DaQi0510/SignalCreater/盖章合同.docx

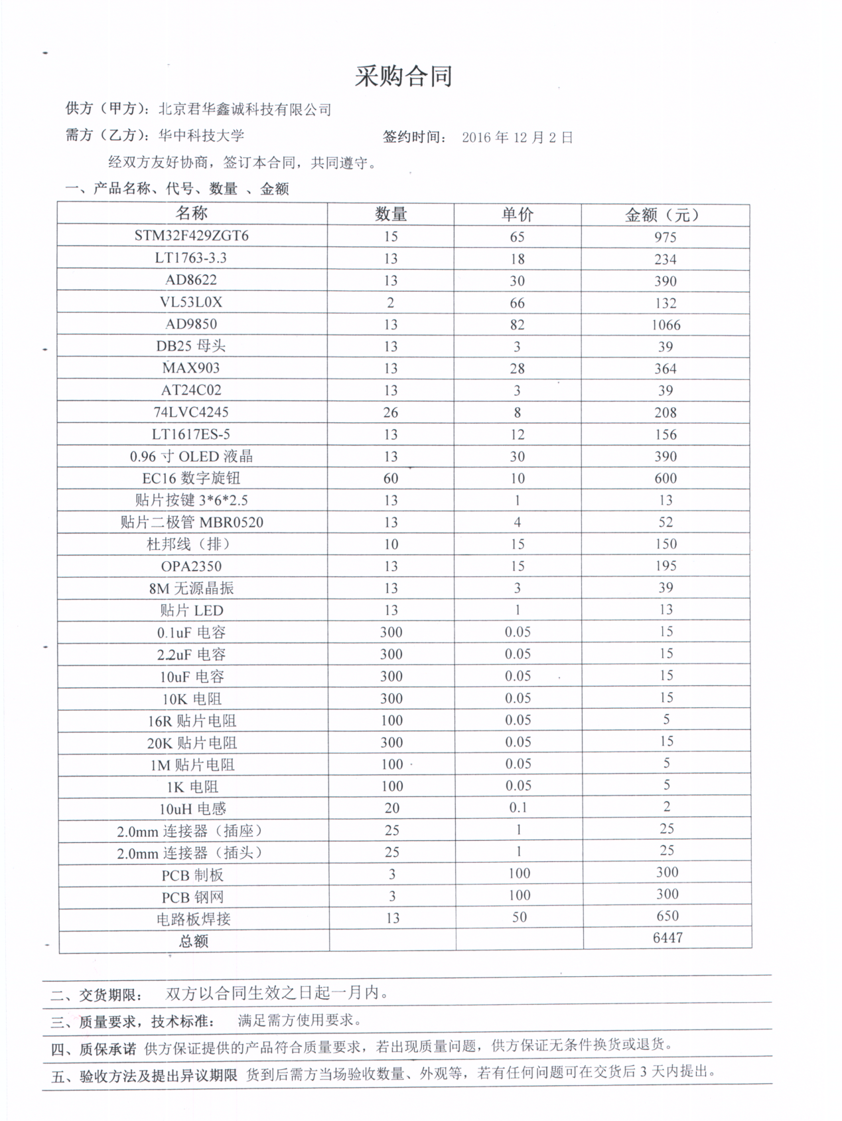
[picture p2: figure]
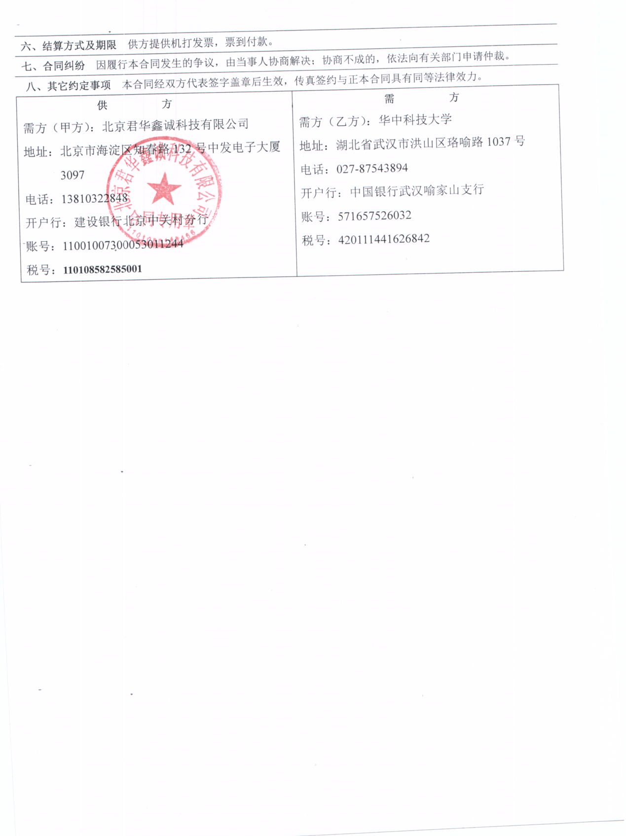
[picture p3: figure]
