DaQi0510/SignalCreater/合同要求/照片 011.jpg

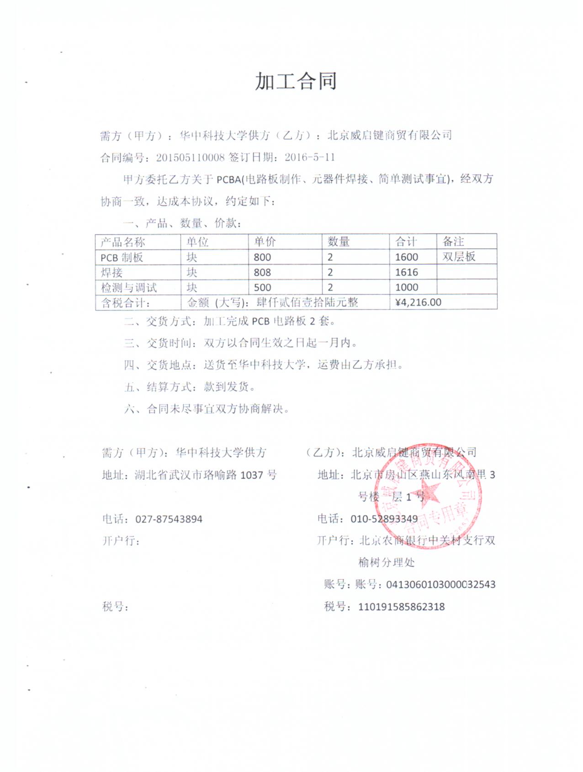
合同要求/照片 011.jpg
