DaQi0510/SignalCreater/合同要求/材料清单.docx

加工清单

付款单位：华中科技大学

产品名称 | 单位 | 单价 | 数量 | 合计 | 备注
PCB制板 | 块 | 800 | 2 | 1600 | 双层板
焊接 | 块 | 808 | 2 | 1616
检测与调试 | 块 | 500 | 2 | 1000
含税合计： | 金额 (大写)：肆仟贰佰壹拾陆元整 | | | ¥4,216.00
