DaQi0510/SignalCreater/金额明细.xlsx

购货单位：华中科技大学 （总计6447元）
名称 | 数量 | 单价 | 金额（元）
STM32F429ZGT6 | 15 | 65 | 975
LT1763-3.3 | 13 | 18 | 234
AD8622 | 13 | 30 | 390
VL53L0X | 2 | 66 | 132
AD9850 | 13 | 82 | 1066
DB25母头 | 13 | 3 | 39
MAX903 | 13 | 28 | 364
AT24C02 | 13 | 3 | 39
74LVC4245 | 26 | 8 | 208
LT1617ES-5 | 13 | 12 | 156
0.96寸OLED液晶 | 13 | 30 | 390
EC16数字旋钮 | 60 | 10 | 600
贴片按键3*6*2.5 | 13 | 1 | 13
贴片二极管MBR0520 | 13 | 4 | 52
杜邦线（排） | 10 | 15 | 150
OPA2350 | 13 | 15 | 195
8M无源晶振 | 13 | 3 | 39
贴片LED | 13 | 1 | 13
0.1uF电容 | 300 | 0.05 | 15
2.2uF电容 | 300 | 0.05 | 15
10uF电容 | 300 | 0.05 | 15
10K电阻 | 300 | 0.05 | 15
16R贴片电阻 | 100 | 0.05 | 5
20K贴片电阻 | 300 | 0.05 | 15
1M贴片电阻 | 100 | 0.05 | 5
1K电阻 | 100 | 0.05 | 5
10uH电感 | 20 | 0.1 | 2
2.0mm连接器（插座） | 25 | 1 | 25
2.0mm连接器（插头） | 25 | 1 | 25
PCB制板 | 3 | 100 | 300
PCB钢网 | 3 | 100 | 300
电路板焊接 | 13 | 50 | 650
