DaQi0510/SignalCreater/PCB/Ven2.0/DDS料单.xls

Comment | Footprint | Quantity | Value
Capacitor-0603 | 0603 | 200 | 0.1uF
Capacitor-0603 | 0603 | 20 | 4.7uF
Capacitor-0603 | 0603 | 20 | 10nF
Capacitor-0805 | 0805 | 20 | 0.47uF
Capacitor-0805 | 0805 | 20 | 4.7uF
Resistor-0603 | 0603 | 100 | 10k
Resistor-0603 | 0603 | 10 | 24.9k
Resistor-0603 | 0603 | 10 | 73.2k
DB25 | DB25母头 | 3 | DB25母头(90度弯角)
LED | LED-0805(红色) | 5 | LED
OPA2350 | SOIC 8P | 3
MAX903 | SOIC 8P | 3
AT24C02 | AT24C02 | 3 | 贴片
74LVC4245 | 74LVC4245-PW | 6
LT1617ES-5 | SOT23-5 | 3 | LT1617ES-5
LT1763-3.3 | LT1763-3.3 | 3 | 贴片
3225无源晶振 | 3225无源晶振 | 3 | 8M
贴片二极管 | 贴片二极管 | 10 | MBR0520
贴片按键3*6*2.5 |  | 10
STM32F407ZGT6 |  | 3
