DaQi0510/SignalCreater/(list of files, drawings)

Other design files:
PCB/Ven1.0/DDS/AD9851.SchDoc
PCB/Ven1.0/DDS/AD9851_2.SchDoc
PCB/Ven1.0/DDS/DDS.PrjPcb
PCB/Ven1.0/DDS/MCU.SchDoc
PCB/Ven1.0/DDS/Module.SchDoc
PCB/Ven1.0/DDS/Power.SchDoc
PCB/Ven1.0/DDS/Top.SchDoc
PCB/Ven2.0/DDS.PcbDoc
PCB/Ven2.0/DDS.PrjPcb
PCB/Ven2.0/DDS.SchDoc
PCB/Ven2.0/MCU.SchDoc
PCB/Ven2.0/Module.SchDoc
PCB/Ven2.0/Power.SchDoc
PCB/Ven2.0/TOP.SchDoc
