DaQi0510/SignalCreater/STM32F407/HARDWARE/AT24C02/AT24C02.h

#ifndef __AT24C02_H
#define __AT24C02_H

#include "stm32f4xx_gpio.h"
#include "stm32f4xx_rcc.h"
#include "sys.h"

//IO方向设置
#define AT24C02_SDA_IN()  {GPIOE->MODER&=~(3<<(12*2));GPIOE->MODER|=0<<12*2;}	//PD13输入模式
#define AT24C02_SDA_OUT() {GPIOE->MODER&=~(3<<(12*2));GPIOE->MODER|=1<<12*2;} //PD13输出模式
//IO操作函数	 
#define AT24C02_SCL    PEout(11)      //SCL
#define AT24C02_SDA    PEout(12)      //SDA	 
#define AT24C02_READ_SDA   PEin(12)   //读取SDA 

void SetDeviceInformation(u8 *Information,u8 Length);
void GetDeviceInformation(void);

void AT24C02_GPIO_Init(void);
void AT24C02_Init(void);
u8 AT24C02_ReadOneByte(u8 ReadAddr);
void AT24C02_WriteOneByte(u8 WriteAddr,u8 DataToWrite);
void AT24C02_Read(u8 ReadAddr,u8 *pBuffer,u8 NumToRead);
void AT24C02_Write(u8 WriteAddr,u8 *pBuffer,u8 NumToWrite);
void AT24C02_IIC_Start(void);
void AT24C02_IIC_Stop(void);
u8 AT24C02_IIC_Wait_Ack(void);
void AT24C02_IIC_Ack(void);
void AT24C02_IIC_NAck(void);
void AT24C02_Send_Byte(u8 TxData);
u8 AT24C02_Read_Byte(u8 Ack);

#endif
