DaQi0510/SignalCreater/(commit log)

2016-11-17 信号发生器第一版
    [AD9851.SchDoc, AD9851_2.SchDoc, DDS.CSV, DDS.PcbDoc, DDS.PrjPcb, DDS.SchDoc, DDS.xls, DDS1.xls]
2016-11-17 硬件改版
    [DDS.PrjPcb, DDS.SchDoc, DDS.xls, DDS料单.xls, MCU.SchDoc, Module.SchDoc, Power.SchDoc, TOP.SchDoc]
2016-11-22 硬件改版程序更新
    [DDS.PrjPcb]
2016-12-08 更改9 18 19三个引脚开断时间
    [发票.xlsx]
2016-12-08 添加合同等
    [DDS.CSV, DDS1.xls, 发票.xlsx, 金额明细.xlsx]
